ScholliYT/LED-Matrix-16x16/README.md

# LED-Matrix-16x16
## A 16x16 RGB LED Matrix controlled by DMX over wifi

__Some facts:__
- 256 RGB LEDs
- 768 DMX Channels
- Teensy 3.6 as Main Controller
- ESP8266 as ArtNet Node
- 3 TLC5940s for controlling brightness
- 2 74CH595 Shift Registers for multiplexing

## History
So, this is the second LED Matrix we are building. The first one was a bit smaller (10x10) and used shift registers only for controlling the LEDs. We weren't that happy about the limitation we got using shift registers only. We ran into refresh rate problems while trying to increase possible grayscale values. We ended up with 8bit grayscale (0-255).

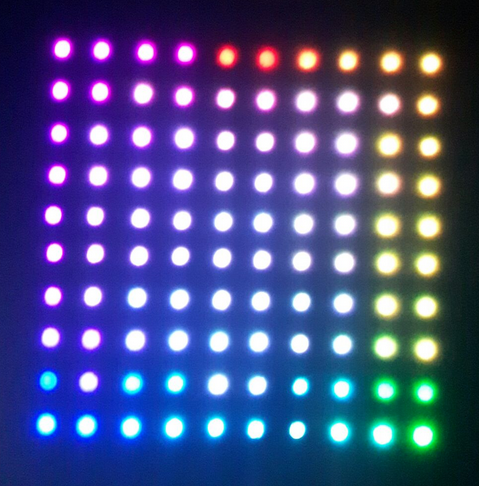
[picture p1: docs/images/oldMatrix.png]
old Matrix The old 10x10 Matrix


## The plan
##### So the basic data flow should look like this
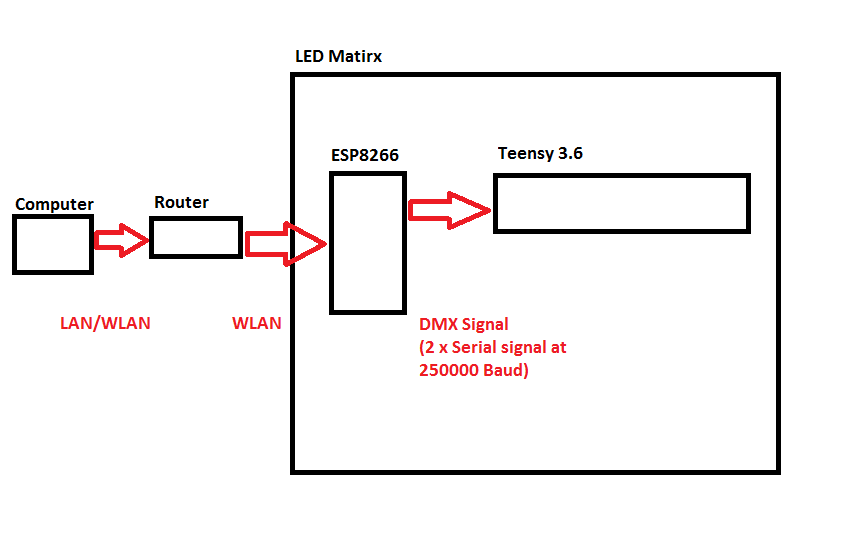
[picture p2: docs/images/function.png]
dataflow function - Data flow


## Schematic
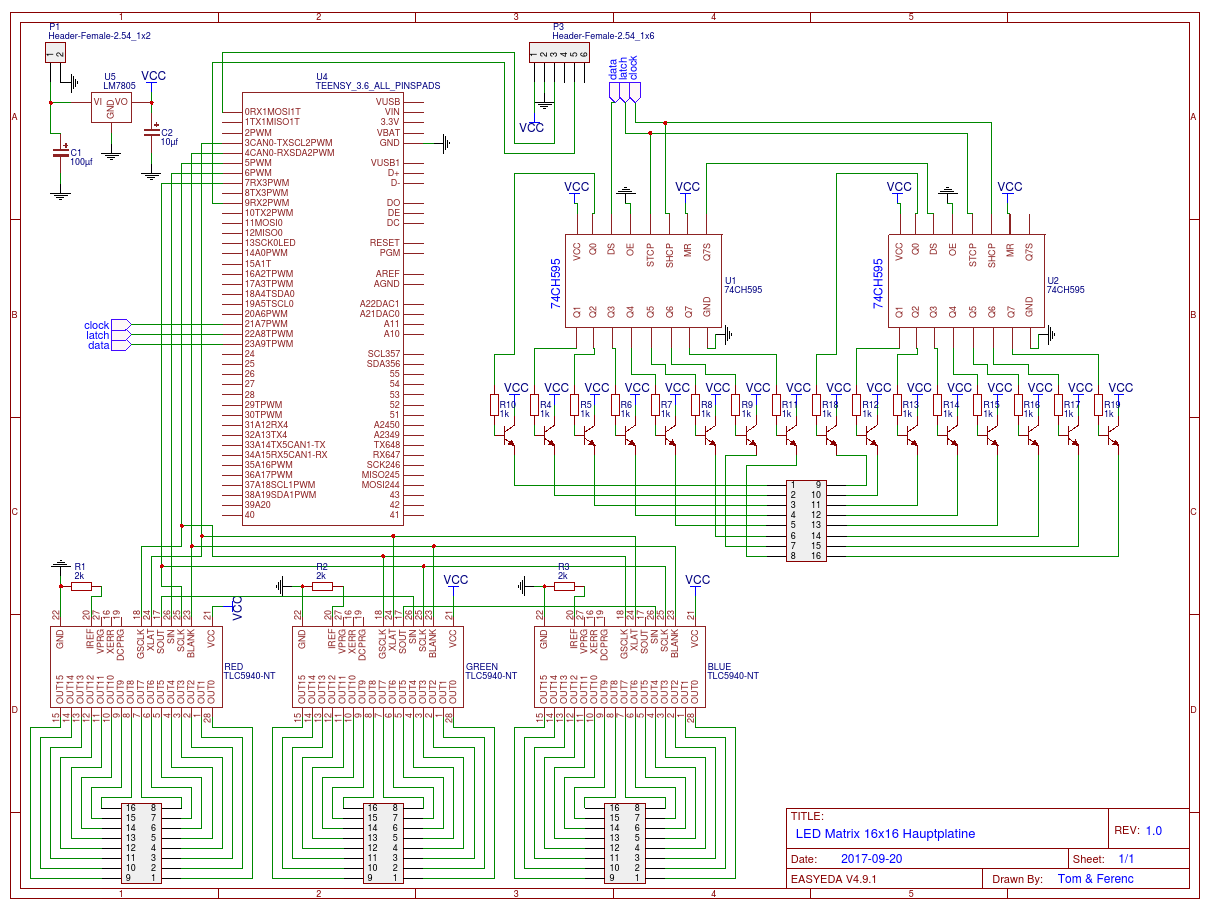
[picture p3: Schematics/Hauptplatine.png]
MainCircuitBoard Circuit Board


## How multiplexing works
##### This are some images explaining how multiplexing with a LED Matrix works
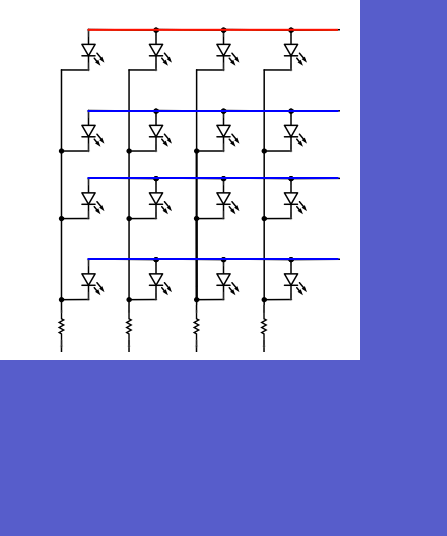
[picture p4: docs/images/multiplexing1.gif]
multiplexing1 Multiplexing

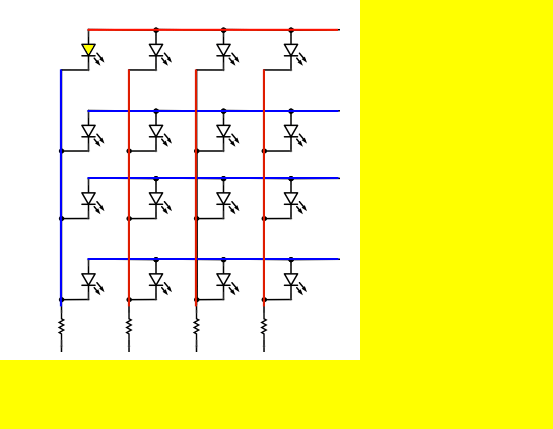
[picture p5: docs/images/multiplexing2.gif]
multiplexing2 Multiplexing


The images are from [this](http://www.instructables.com/id/Multiplexing-with-Arduino-and-the-74HC595/) instrucable. There you can also find more information on multiplexing: 

## The building process

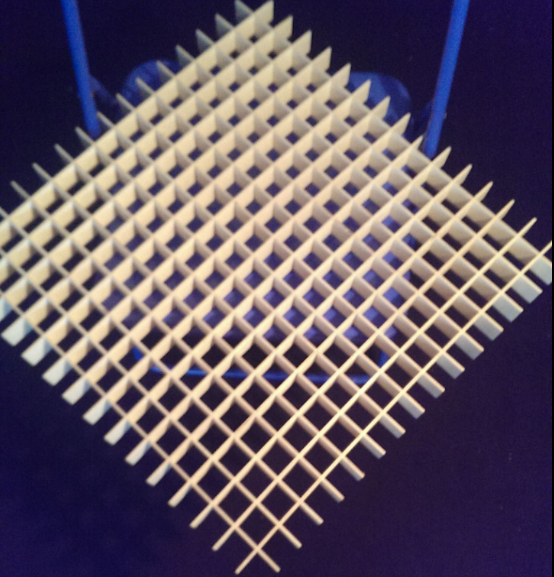
[picture p6: docs/images/frame.png]
main frame The main frame

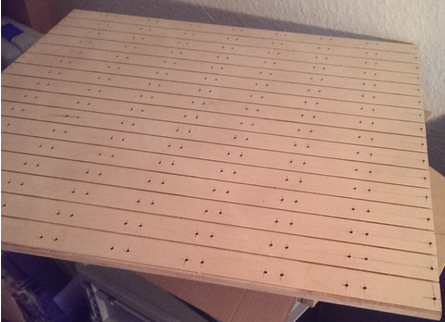
[picture p7: docs/images/Back.png]
Backplate The main backplate


##### So after some weekends of soldering 4 wires to every single SMD LED we finally made it.

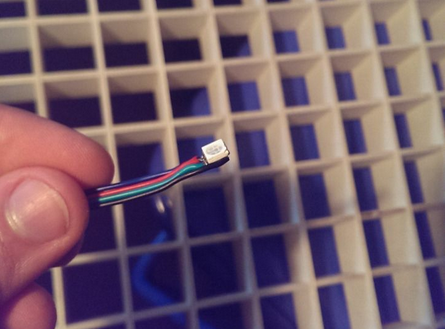
[picture p8: docs/images/firstled.png]
First LED The first finished LED

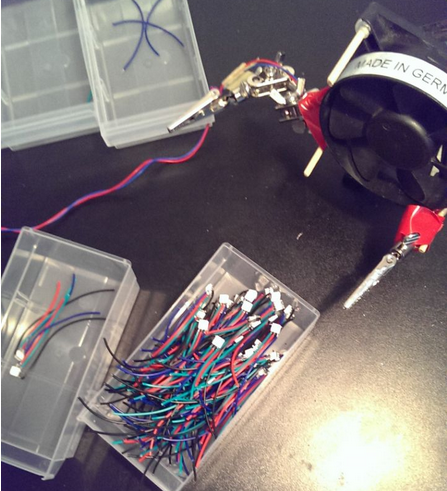
[picture p9: docs/images/working.png]
Soldering LEDs The process of soldering all wires to 256 LEDs


##### Lets start soldering them on the frame...

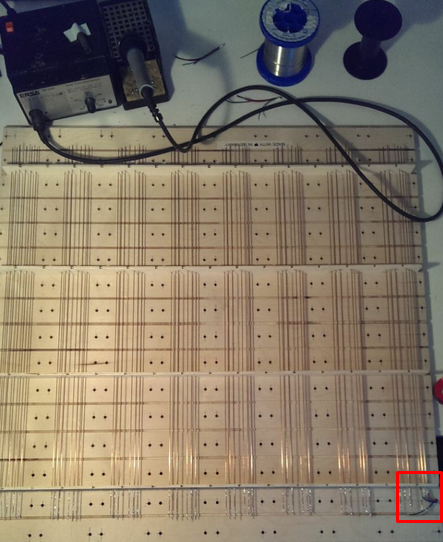
[picture p10: docs/images/firstmountedled.png]
First The first LED is mounted

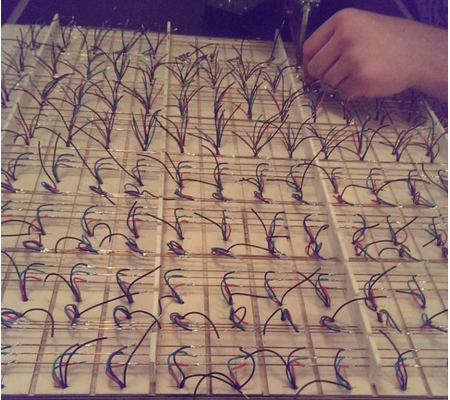
[picture p11: docs/images/process.png]
Process We're making progress


##### After dozen weekends spend soldering we made it

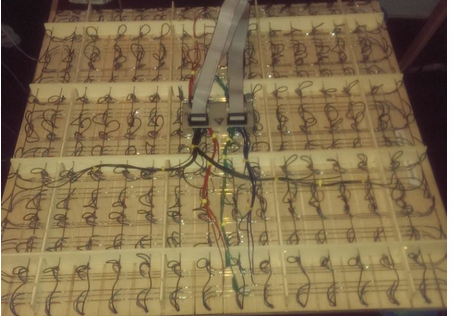
[picture p12: docs/images/finished.png]
Finished Finally we made it


## First testing
##### As you can see. It works! :) But there are some LEDs that need to be fixed

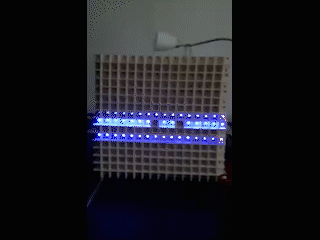
[picture p13: docs/images/working.gif]
working It works

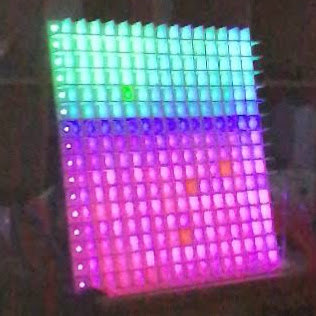
[picture p14: docs/images/working_picture.jpg]
working It works


## DMX
Using ArtNet Node running on an ESP8266. See [this awesome project](https://github.com/mtongnz/ESP8266_ArtNetNode_v2).
