ScholliYT/LED-Matrix-16x16/docs/images/almost.png

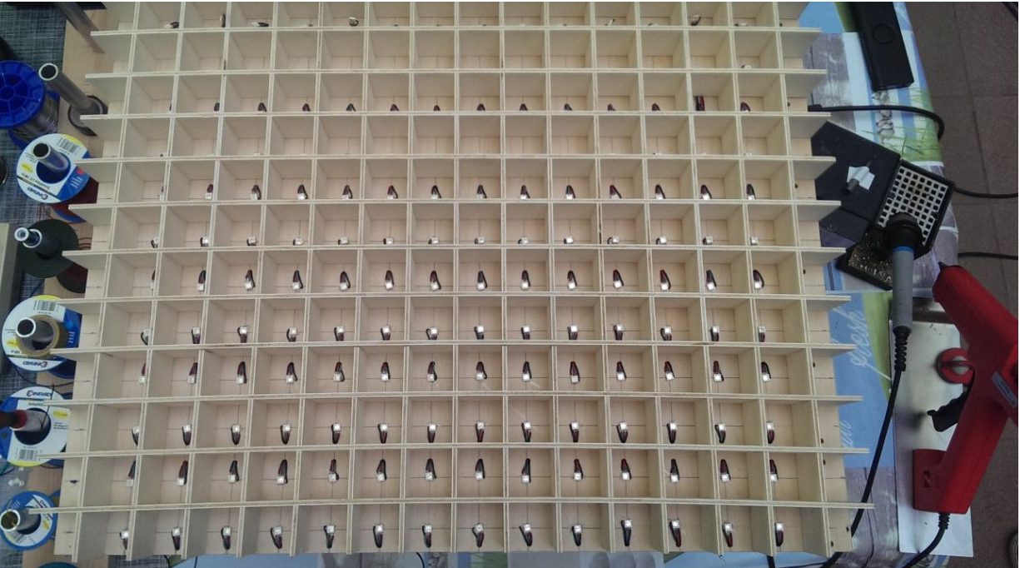
docs/images/almost.png
