ScholliYT/LED-Matrix-16x16/Schematics/ESPPlatine.png

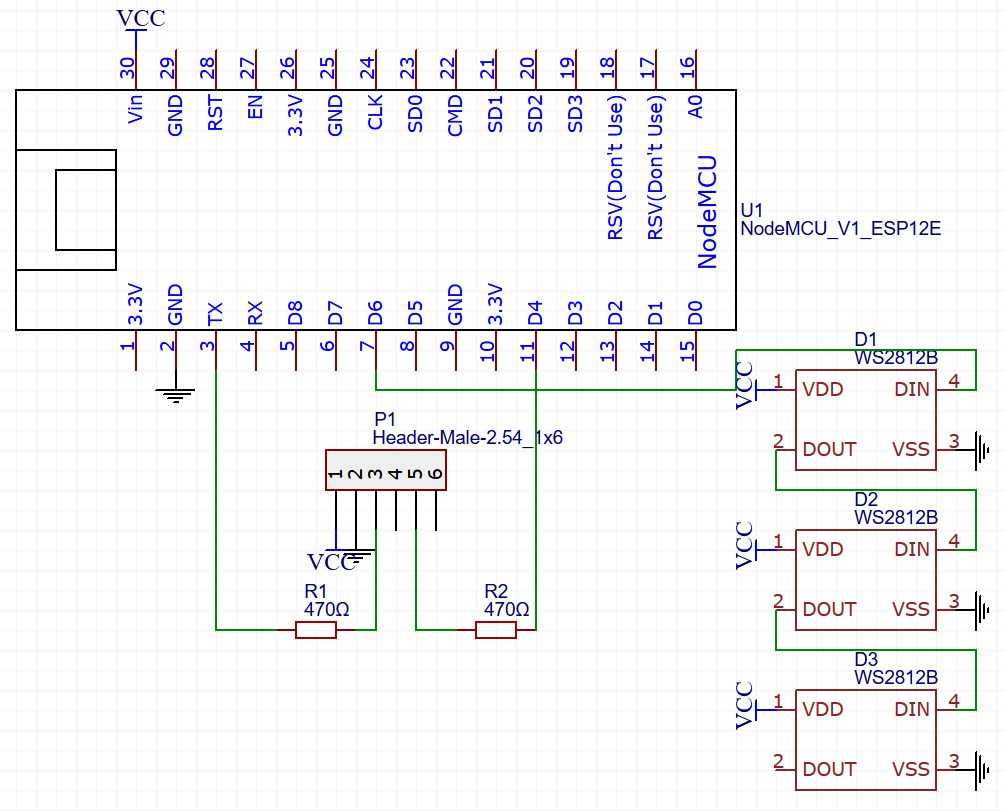
Schematics/ESPPlatine.png
