ScholliYT/LED-Matrix-16x16/(threads)

Thread 5 (2018-01-12):

LED Common Type?

adammhaile, 2018-01-12:
Really just a question... I wanted to confirm, are the LEDs you used Common anode? I believe that's what you need for the TLC5940 but wasn't sure if that swapped when using the shift registers to multiplex it all?

ScholliYT, 2018-01-12:
I used the standard 5050 SMD RGB Leds. They have 3 anodes and 3 cathodes. I then soldered all 3 anodes together which then connect to a shift register. The 3 cathodes connect each to one pin on the TLC

adammhaile, 2018-01-12:
Awesome. Thanks :)

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

ScholliYT, 2018-11-05:
Close

Closed 2018-11-05.

Thread 7 (2021-04-29):

High side transistor type?

okh-mzny, 2021-04-29:
I'm looking to build a comparable Matrix.
I have a single color and an STP16CPS05 as a sink driver, I'm looking to switch about 30mA per LED with a total of 480mA per transistor. What kind of transistor did you use in your design? The transistors aren't marked on your schematic :/

Thank you

ScholliYT, 2021-04-29:
We used SS8050 transistors. However, we built a complete new pcb with different components. We used mosfets instead of transistors for switching.

Closed 2022-01-10.
