ScholliYT/LED-Matrix-16x16/Code/Code.ino

/*
Basic Pin setup:
------------                                  ---u----
Teensy    13|-> Onbard LED    OUT1 |1     28| OUT channel 0
12|                           OUT2 |2     27|-> GND (VPRG)
11|                           OUT3 |3     26|-> SIN (pin 11)
10|                           OUT4 |4     25|-> SCLK (pin 13)
9|-> DMX.B                     .  |5     24|-> XLAT (pin 9)
8|                             .  |6     23|-> BLANK (pin 10)
7|-> SCLK (pin 25)             .  |7     22|-> GND
6|-> SIN (pin 26)              .  |8     21|-> VCC (+5V)
5|-> GSCLK (pin 18)            .  |9     20|-> 2K Resistor -> GND
4|-> BLANK (pin 23)            .  |10    19|-> +5V (DCPRG)
3|-> XLAT (pin 24)             .  |11    18|-> GSCLK (pin 3)
2|                             .  |12    17|-> SOUT
1|                             .  |13    16|-> XERR
0|-> DMX.A                   OUT14|14    15| OUT channel 15
------------                                  --------
-  The 2K resistor between TLC pin 20 and GND will let ~20mA through each
LED.  To be precise, it's I = 39.06 / R (in ohms).  This doesn't depend
on the LED driving voltage.
- (Optional): put a pull-up resistor (~10k) between +5V and BLANK so that
all the LEDs will turn off when the Arduino is reset.
If you are daisy-chaining more than one TLC, connect the SOUT of the first
TLC to the SIN of the next.  All the other pins should just be connected
together:
BLANK on Arduino -> BLANK of TLC1 -> BLANK of TLC2 -> ...
XLAT on Arduino  -> XLAT of TLC1  -> XLAT of TLC2  -> ...
The one exception is that each TLC needs it's own resistor between pin 20
and GND.
*/
// Imports
#include "Tlc5940.h"
#include "TeensyDMX.h"
// Debug
#define DEBUG 0
#define DEBUGVALUES 0
#define DEBUGDMX 0
#define DEBUGMULTIPLEX 0
#define DEBUGREFRESHRATE 0
#if DEBUGREFRESHRATE
long lastLoop = 0;
#endif
// Matrix Size
#define MATRIX_ROWS 16
#define MATRIX_COLUMNS 16
// Shift register PINS
#define SData 23
#define SLatch 22
#define SClock 21
// DMX Data
uint8_t data[MATRIX_ROWS * MATRIX_COLUMNS * 3];
// DMX Connection
namespace teensydmx =::qindesign::teensydmx;
teensydmx::Receiver dmxRxA
{
  Serial1
};

teensydmx::Receiver dmxRxB
{
  Serial2
};

void setup()
{
  Serial.begin(250000);
  Serial.print("\n\n\n\n\n");
  Serial.println("Starting LED Matrix");
  Serial.printf("TLCs: %d\n", NUM_TLCS);
  Serial.printf("Dimension: %dx%d\n", MATRIX_ROWS, MATRIX_COLUMNS);
  pinMode(SData, OUTPUT);
  pinMode(SLatch, OUTPUT);
  pinMode(SClock, OUTPUT);
  pinMode(13, OUTPUT);
  dmxRxA.begin();
  dmxRxB.begin();
  /*for (int i = 0; i < 5; i++)
  {
  digitalWrite(13, HIGH);
  delay(50);
  digitalWrite(13, LOW);
  delay(50);
  }*/
  digitalWrite(13, HIGH);
  delay(500);
  digitalWrite(13, LOW);
  delay(500);
  digitalWrite(13, HIGH);
/* Call Tlc.init() to setup the tlc.
You can optionally pass an initial PWM value (0 - 4095) for all channels.*/
  Tlc.init();
}

void loop()
{
  #if DEBUGREFRESHRATE
  long time = micros() - lastLoop;
  Serial.printf("Refresh Time µs: %d. Hz: %d\n", time, 1000000 / time);
  lastLoop = micros();
  #endif

  #if DEBUGDMX
  long micGetDMX = micros();
  #endif

  getDMX();

  #if DEBUGDMX
  Serial.printf("Got new DMX Values. Time µs: %d\n", micros() - micGetDMX);
  #endif
  Tlc.setAll(0);
  for (int row = 0; row < MATRIX_ROWS; ++row)
  {
    #if DEBUGMULTIPLEX
    long micTlc = micros();
    #endif
    for (int column = 0; column < MATRIX_COLUMNS; ++column)
    {

      #if DEBUGVALUES
      Serial.printf("[%d %d %d] ", data[row * 16 * 3 + column * 3 + 0], data[row * 16 * 3 + column * 3 + 1], data[row * 16 * 3 + column * 3 + 2]);
      #endif

      // Red
      Tlc.set(column                    , data[row * 48 + column * 3    ] * 16);

    }

    #if DEBUGMULTIPLEX
    Serial.printf("Set   Tlcs. Time µs: %d\n", micros() - micTlc);
    #endif

    #if DEBUGVALUES
    Serial.print("\n");
    #endif

    #if DEBUGMULTIPLEX
    long micOutput = micros();
    #endif
    while(Tlc.update()); //Wait to shift data
    clearMultiplex();    // --- clear Shift register in meanwhile ---- Data COULD already be latched
    while(tlc_needXLAT); //Wait to latch data
    multiplex(row);
    #if DEBUGMULTIPLEX
    Serial.printf("Send  Data. Time µs: %d\n", micros() - micOutput);
    #endif

    delayMicroseconds(500); //Give LEDs some ontime - Best possible value: 900
  }
  Tlc.setAll(0);
  for (int row = 0; row < MATRIX_ROWS; ++row)
  {
    #if DEBUGMULTIPLEX
    long micTlc = micros();
    #endif
    for (int column = 0; column < MATRIX_COLUMNS; ++column)
    {

      #if DEBUGVALUES
      Serial.printf("[%d %d %d] ", data[row * 16 * 3 + column * 3 + 0], data[row * 16 * 3 + column * 3 + 1], data[row * 16 * 3 + column * 3 + 2]);
      #endif


      // Green
      Tlc.set(column + MATRIX_COLUMNS   , data[row * 48 + column * 3 + 1] * 16);

    }

    #if DEBUGMULTIPLEX
    Serial.printf("Set   Tlcs. Time µs: %d\n", micros() - micTlc);
    #endif

    #if DEBUGVALUES
    Serial.print("\n");
    #endif

    #if DEBUGMULTIPLEX
    long micOutput = micros();
    #endif
    while(Tlc.update()); //Wait to shift data
    clearMultiplex();    // --- clear Shift register in meanwhile ---- Data COULD already be latched
    while(tlc_needXLAT); //Wait to latch data
    multiplex(row);
    #if DEBUGMULTIPLEX
    Serial.printf("Send  Data. Time µs: %d\n", micros() - micOutput);
    #endif

    delayMicroseconds(500); //Give LEDs some ontime - Best possible value: 900
  }
  Tlc.setAll(0);
  for (int row = 0; row < MATRIX_ROWS; ++row)
  {
    #if DEBUGMULTIPLEX
    long micTlc = micros();
    #endif
    for (int column = 0; column < MATRIX_COLUMNS; ++column)
    {

      #if DEBUGVALUES
      Serial.printf("[%d %d %d] ", data[row * 16 * 3 + column * 3 + 0], data[row * 16 * 3 + column * 3 + 1], data[row * 16 * 3 + column * 3 + 2]);
      #endif


      // Blue
      Tlc.set(column + MATRIX_COLUMNS *2, data[row * 48 + column * 3 + 2] * 16);
    }

    #if DEBUGMULTIPLEX
    Serial.printf("Set   Tlcs. Time µs: %d\n", micros() - micTlc);
    #endif

    #if DEBUGVALUES
    Serial.print("\n");
    #endif

    #if DEBUGMULTIPLEX
    long micOutput = micros();
    #endif
    while(Tlc.update()); //Wait to shift data
    clearMultiplex();    // --- clear Shift register in meanwhile ---- Data COULD already be latched
    while(tlc_needXLAT); //Wait to latch data
    multiplex(row);
    #if DEBUGMULTIPLEX
    Serial.printf("Send  Data. Time µs: %d\n", micros() - micOutput);
    #endif

    delayMicroseconds(500); //Give LEDs some ontime - Best possible value: 900
  }

  #if DEBUGVALUES
  Serial.print("\n\n\n");
  #endif

}

void getDMX()
{
  uint8_t tempA[510];
  int readA = dmxRxA.readPacket(tempA, 1, 510);
  if (readA == 510)
  {

    #if DEBUG
    Serial.printf("DMX.A: %d\n", readA);
    #endif

    memcpy(data, tempA, sizeof(tempA));
  }
  else
    if (readA == -1)
    {

    #if DEBUG
      Serial.println("There is no DMX package available for port A");
    #endif

    }
    else
    {
      Serial.printf("%s: %d\n", "Error reading all 510 required DMX Channels from DMX.A. Read: ", readA);
    }
    uint8_t tempB[258];
    int readB = dmxRxB.readPacket(tempB, 1, 258);
    if (readB == 258)
    {

    #if DEBUG
      Serial.printf("DMX.B: %d\n", readB);
    #endif

      memcpy(data + 510, tempB, sizeof(tempB));
    }
    else if (readB == -1)
    {

    #if DEBUG
        Serial.println("There is no DMX package available for port B");
    #endif

    }
    else
    {
      Serial.printf("%s: %d\n", "Error reading all 258 required DMX Channels from DMX.A. Read: ", readB);
    }
}

void multiplex(int row)
{
  digitalWriteFast(SLatch, LOW); // Latch Low
  uint16_t shift_data = 1 << row;
  // ============================= SHIFTOUT =============================
  for (uint16_t i = 0; i < 16; i++)
  {
    digitalWriteFast(SData, !!(shift_data & (1 << i)));
    digitalWriteFast(SClock, HIGH);
    __asm__ __volatile__ ("nop\n\t");
    __asm__ __volatile__ ("nop\n\t");
    digitalWriteFast(SClock, LOW);
  }
  // ============================= SHIFTOUT =============================
  digitalWriteFast(SData, LOW);
  digitalWriteFast(SLatch, HIGH); // Latch High
}

void clearMultiplex()
{
  digitalWriteFast(SLatch, LOW); // Latch Low
  // ============================= SHIFTOUT =============================
  for (uint16_t i = 0; i < 16; i++)
  {
    digitalWriteFast(SData, LOW);
    digitalWriteFast(SClock, HIGH);
    __asm__ __volatile__ ("nop\n\t");
    __asm__ __volatile__ ("nop\n\t");
    digitalWriteFast(SClock, LOW);
  }
  // ============================= SHIFTOUT =============================
  digitalWriteFast(SLatch, HIGH); // Latch High
}
