ScholliYT/LED-Matrix-16x16/(commit log)

2017-08-06 New Schematics
2017-12-12 Fixed trace in Schematic
2017-12-12 deletet schematics
2022-01-10 [ImgBot] Optimize images
    *Total -- 8,378.71kb -> 5,755.22kb (31.31%)
    /jinx-2.4/Animations/Dota2Logo_16x16.png -- 18.70kb -> 3.24kb (82.67%)
    /jinx-2.4/Animations/TeamLiquidLogo.png -- 16.73kb -> 3.32kb (80.16%)
    /docs/images/function.png -- 14.92kb -> 5.57kb (62.7%)
    /docs/images/firstled.png -- 374.71kb -> 179.00kb (52.23%)
    /docs/images/almost.png -- 1,711.50kb -> 930.64kb (45.62%)
    /docs/images/oldMatrix.png -- 619.86kb -> 342.08kb (44.81%)
    /docs/images/firstmountedled.png -- 569.33kb -> 328.66kb (42.27%)
    /docs/images/frame.png -- 800.60kb -> 492.92kb (38.43%)
    /docs/images/Back.png -- 270.60kb -> 168.68kb (37.66%)
    /docs/images/finished.png -- 350.66kb -> 227.28kb (35.19%)
    /docs/images/working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
