ScholliYT/LED-Matrix-16x16/(notices)

Notices in the files:
Code/tlc_config.h:
and/or modify it under the terms of the GNU General Public License as
published by the Free Software Foundation, either version 3 of the
License, or (at your option) any later version.
